zkuligowski/Hand-project/photos/received_1306013796596848.jpeg

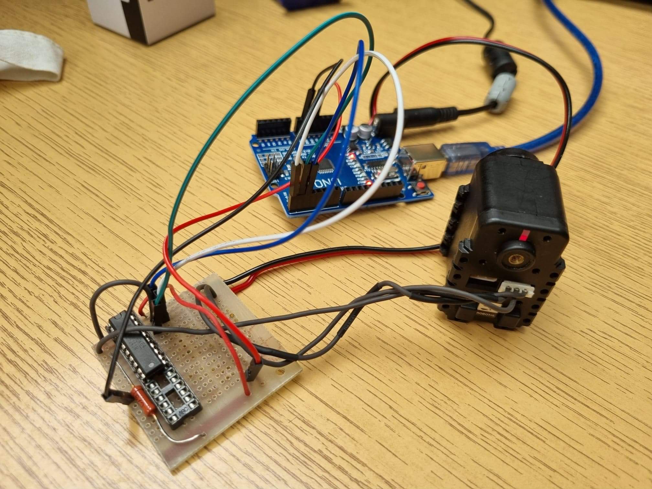
photos/received_1306013796596848.jpeg
