zkuligowski/Hand-project/photos/IMG_20220628_224220.jpg

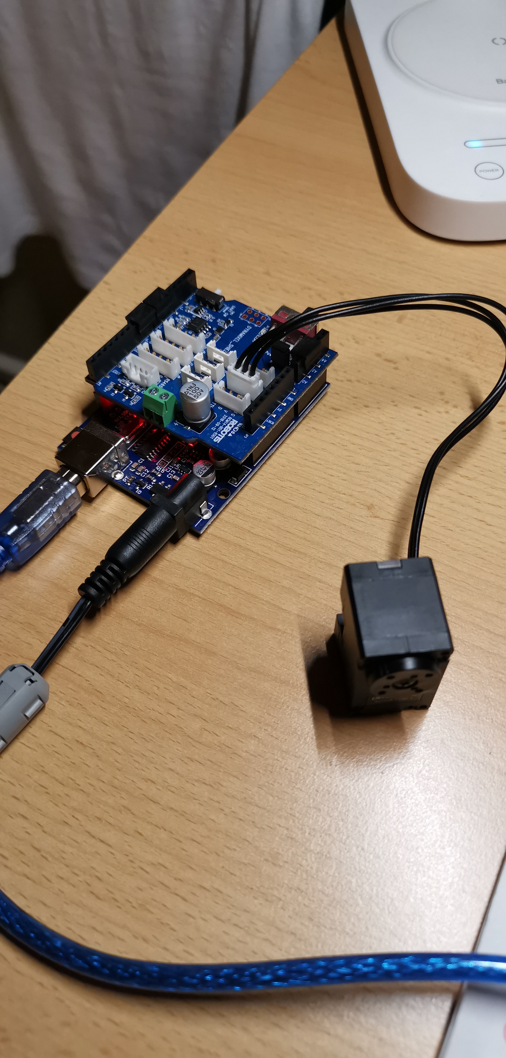
photos/IMG_20220628_224220.jpg
