zkuligowski/Hand-project/photos/received_407627618075618.jpeg

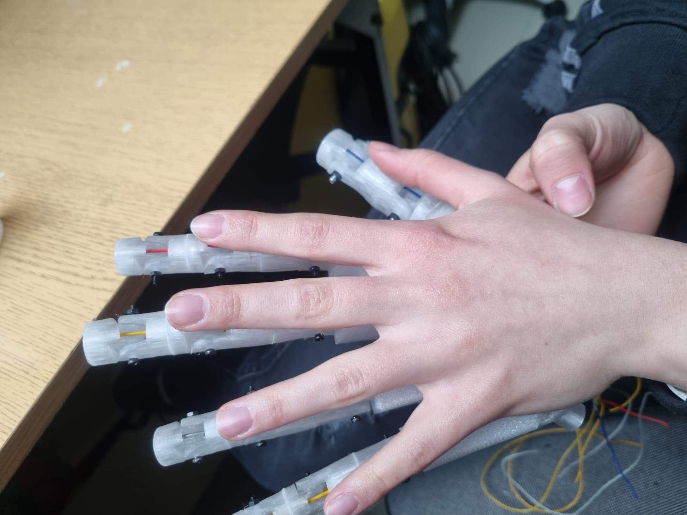
photos/received_407627618075618.jpeg
