zkuligowski/Hand-project/photos/received_569231204782199.jpeg

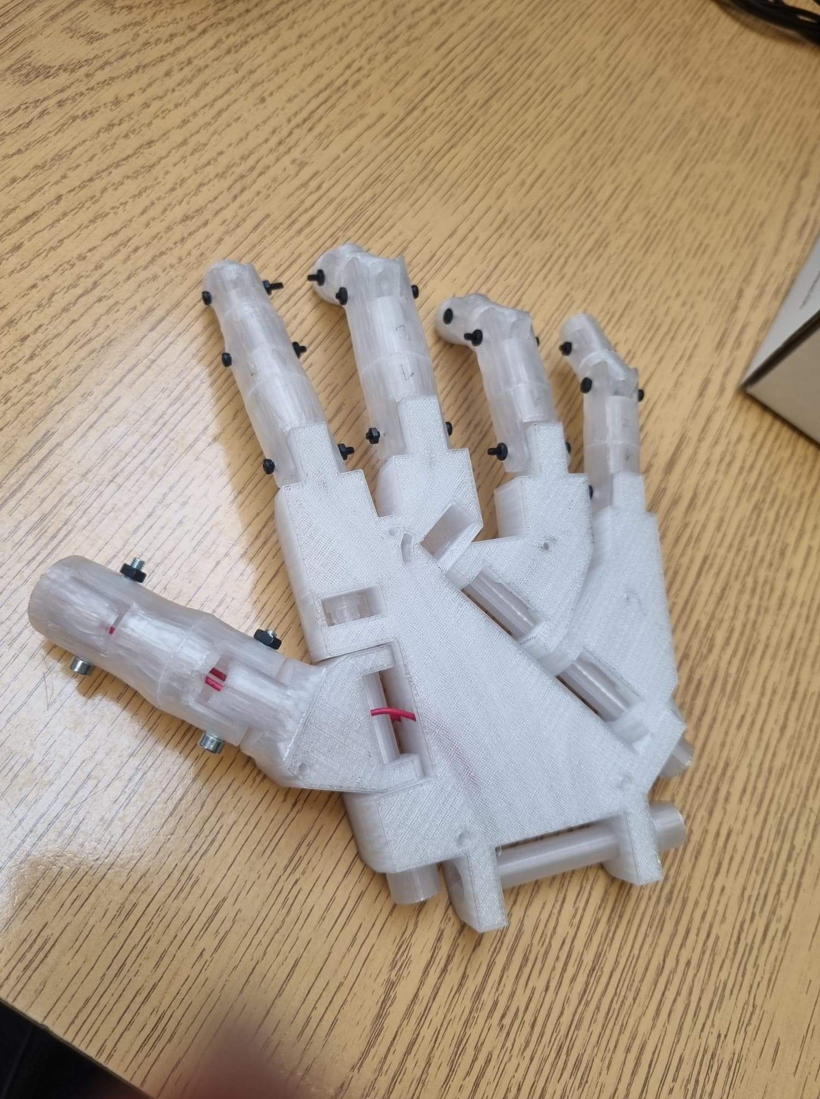
photos/received_569231204782199.jpeg
