zkuligowski/Hand-project/photos/received_1436887240087755.jpeg

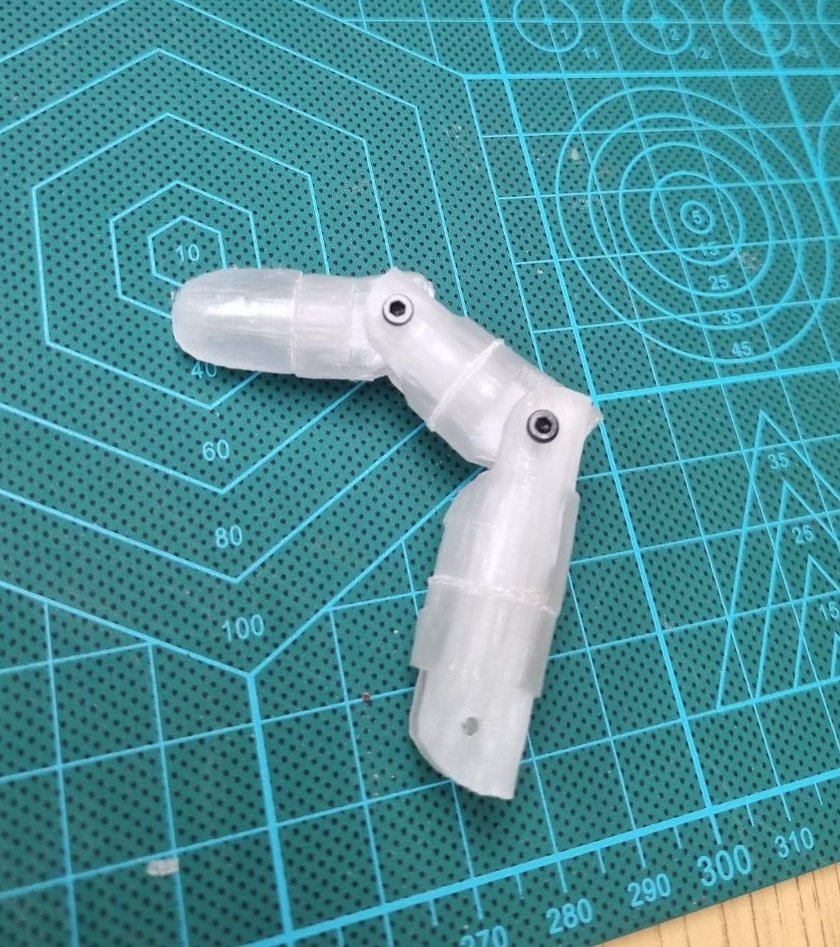
photos/received_1436887240087755.jpeg
