zkuligowski/Hand-project/photos/received_3360359477527232.jpeg

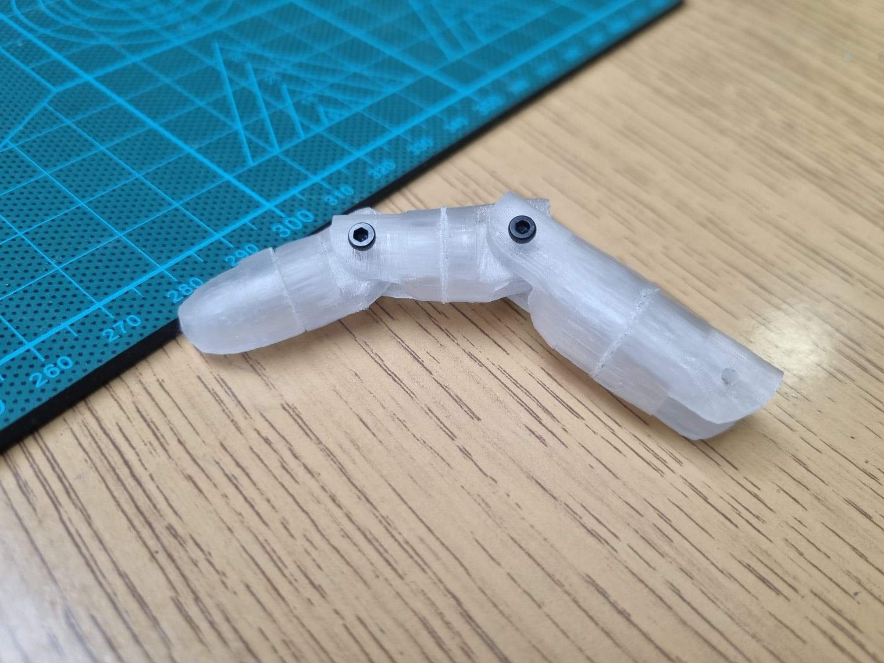
photos/received_3360359477527232.jpeg
