zkuligowski/Hand-project/photos/WhatsApp Image 2022-09-14 at 20.22.26 (1).jpeg

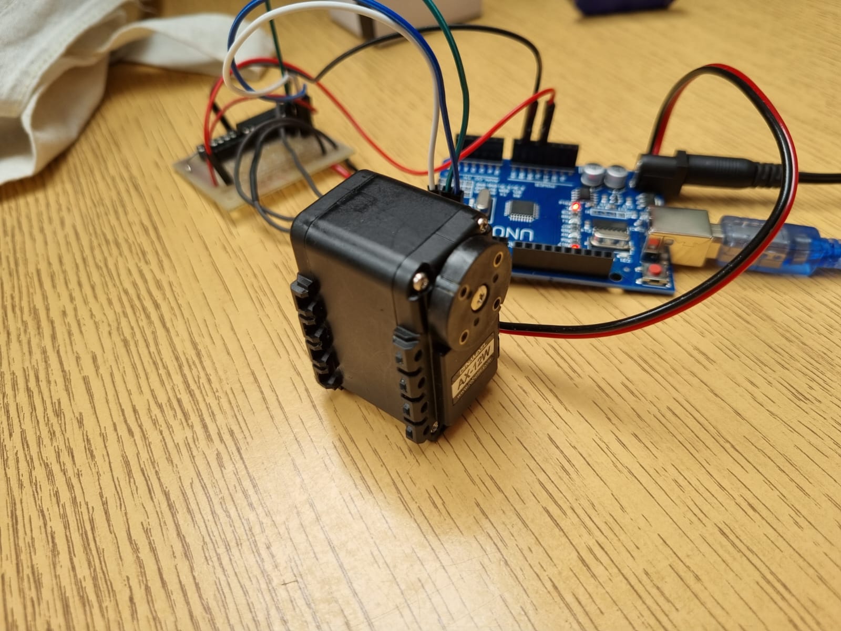
photos/WhatsApp Image 2022-09-14 at 20.22.26 (1).jpeg
