zkuligowski/Hand-project/photos/WhatsApp Image 2022-09-14 at 20.22.27 (3).jpeg

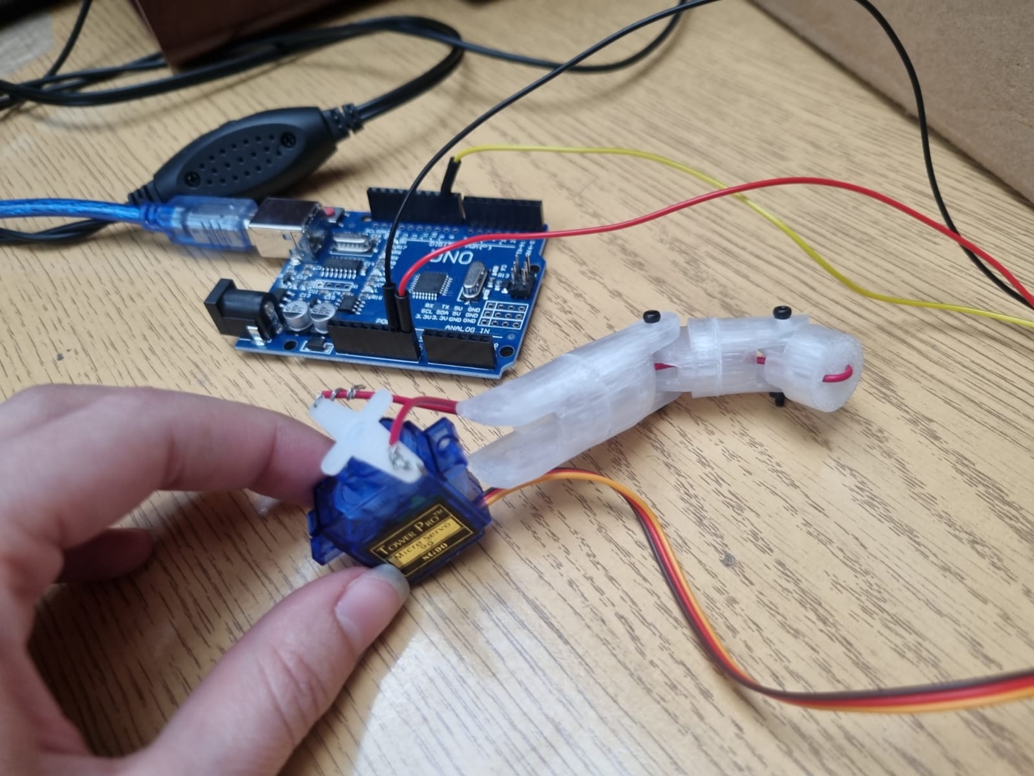
photos/WhatsApp Image 2022-09-14 at 20.22.27 (3).jpeg
