zkuligowski/Hand-project/Code/torque_xc430/torque_xc430.ino

/*******************************************************************************
* Copyright 2016 ROBOTIS CO., LTD.
*
* Licensed under the Apache License, Version 2.0 (the "License");
* you may not use this file except in compliance with the License.
* You may obtain a copy of the License at
*
*     http://www.apache.org/licenses/LICENSE-2.0
*
* Unless required by applicable law or agreed to in writing, software
* distributed under the License is distributed on an "AS IS" BASIS,
* WITHOUT WARRANTIES OR CONDITIONS OF ANY KIND, either express or implied.
* 
* See the License for the specific language governing permissions and
* limitations under the License.
*******************************************************************************/

#include <Dynamixel2Arduino.h>

// Please modify it to suit your hardware.
#if defined(ARDUINO_AVR_UNO) || defined(ARDUINO_AVR_MEGA2560) // When using DynamixelShield
  #include <SoftwareSerial.h>
  SoftwareSerial soft_serial(7, 8); // DYNAMIXELShield UART RX/TX
  #define DXL_SERIAL   Serial
  #define DEBUG_SERIAL soft_serial
  const int DXL_DIR_PIN = 2; // DYNAMIXEL Shield DIR PIN
#elif defined(ARDUINO_SAM_DUE) // When using DynamixelShield
  #define DXL_SERIAL   Serial
  #define DEBUG_SERIAL SerialUSB
  const int DXL_DIR_PIN = 2; // DYNAMIXEL Shield DIR PIN
#elif defined(ARDUINO_SAM_ZERO) // When using DynamixelShield
  #define DXL_SERIAL   Serial1
  #define DEBUG_SERIAL SerialUSB
  const int DXL_DIR_PIN = 2; // DYNAMIXEL Shield DIR PIN
#elif defined(ARDUINO_OpenCM904) // When using official ROBOTIS board with DXL circuit.
  #define DXL_SERIAL   Serial3 //OpenCM9.04 EXP Board's DXL port Serial. (Serial1 for the DXL port on the OpenCM 9.04 board)
  #define DEBUG_SERIAL Serial
  const int DXL_DIR_PIN = 22; //OpenCM9.04 EXP Board's DIR PIN. (28 for the DXL port on the OpenCM 9.04 board)
#elif defined(ARDUINO_OpenCR) // When using official ROBOTIS board with DXL circuit.
  // For OpenCR, there is a DXL Power Enable pin, so you must initialize and control it.
  // Reference link : https://github.com/ROBOTIS-GIT/OpenCR/blob/master/arduino/opencr_arduino/opencr/libraries/DynamixelSDK/src/dynamixel_sdk/port_handler_arduino.cpp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
  #define DXL_SERIAL   Serial3
  #define DEBUG_SERIAL Serial
  const int DXL_DIR_PIN = 84; // OpenCR Board's DIR PIN.
#elif defined(ARDUINO_OpenRB)  // When using OpenRB-150
  //OpenRB does not require the DIR control pin.
  #define DXL_SERIAL Serial1
  #define DEBUG_SERIAL Serial
  const int DXL_DIR_PIN = -1;
#else // Other boards when using DynamixelShield
  #define DXL_SERIAL   Serial1
  #define DEBUG_SERIAL Serial
  const int DXL_DIR_PIN = 2; // DYNAMIXEL Shield DIR PIN
#endif
 

const uint8_t DXL_ID = 1;
const float DXL_PROTOCOL_VERSION = 2.0;

Dynamixel2Arduino dxl(DXL_SERIAL, DXL_DIR_PIN);

//This namespace is required to use Control table item names
using namespace ControlTableItem;

void setup() {
  // put your setup code here, to run once:

  // Set Port baudrate to 57600bps. This has to match with DYNAMIXEL baudrate.
  dxl.begin(57600);
  // Set Port Protocol Version. This has to match with DYNAMIXEL protocol version.
  dxl.setPortProtocolVersion(DXL_PROTOCOL_VERSION);
  // Get DYNAMIXEL information

  
  dxl.torqueOff(DXL_ID);
  dxl.ledOn(DXL_ID);
  int start_position = dxl.getPresentPosition(DXL_ID);
  delay(25);
}

void loop() {
  
int position_servo = dxl.getPresentPosition(DXL_ID);
    delay(25);
int velocity_servo = dxl.getPresentVelocity(DXL_ID);
    delay(25);

  if(position_servo >= (start_position - 10) && position_servo <= (start_position + 10))
  {
    dxl.setGoalVelocity(DXL_ID, velocity_servo);
    dxl.setGoalPosition(DXL_ID, start_position);
  }
}
//   int speed_servo4 = dxl.readSpeed(DXL_ID);
    //delay(25);

    
  //if(speed_servo4 > 1000)
  //{
    //dxl.turn(1,RIGTH,100);
    //dxl.moveSpeed(1,1000, 70);  // Move the Servo radomly from 200 to 800
   // delay(1000);   
  //}
  //else 
  //{
    //dxl.turn(5,LEFT,100);
    //delay(1000);
  //}
    //dxl.end();                 // End Servo Comunication
    /*
    delay(1000);
    
    Serial.begin(9600);              // Begin Serial Comunication
    Serial.println("Servo 4 Position:");
    Serial.println(position_servo4);
    Serial.println("Servo 4 Speed:");
    Serial.println(speed_servo4);
    Serial.println("Servo 5 Position:");
    Serial.println(position_servo5);
    Serial.println("Servo 5 Speed:");
    Serial.println(speed_servo5);
    Serial.end();                     // End the Serial Comunication
    dxl.begin(1000000,2);         // Begin Servo Comunication
 
    delay(1000);
    */
