zkuligowski/Hand-project/photos/1663225740596.jpg

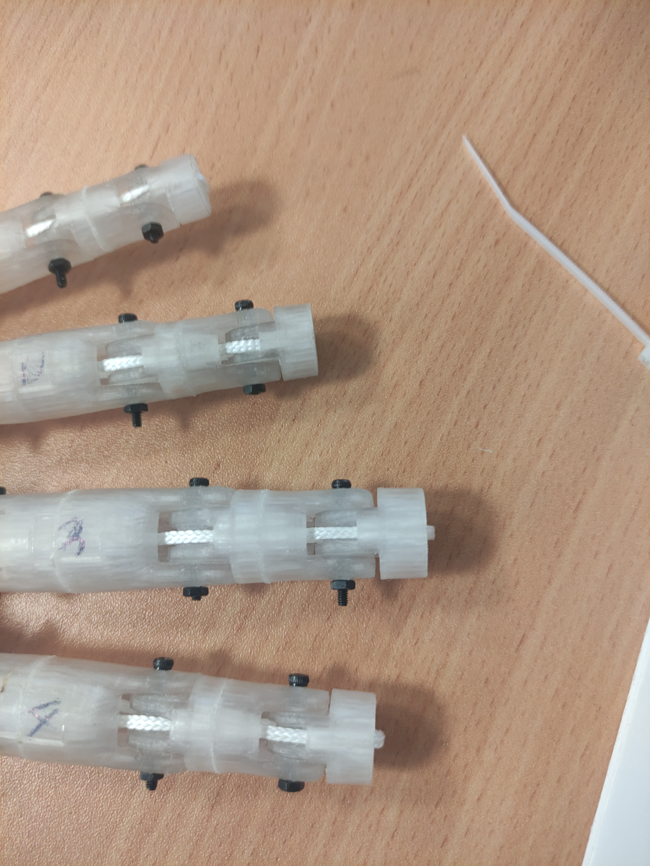
photos/1663225740596.jpg
